Rohit-Kumar-Meena/4-Dof-Scara-Robot/SCARA.jpeg

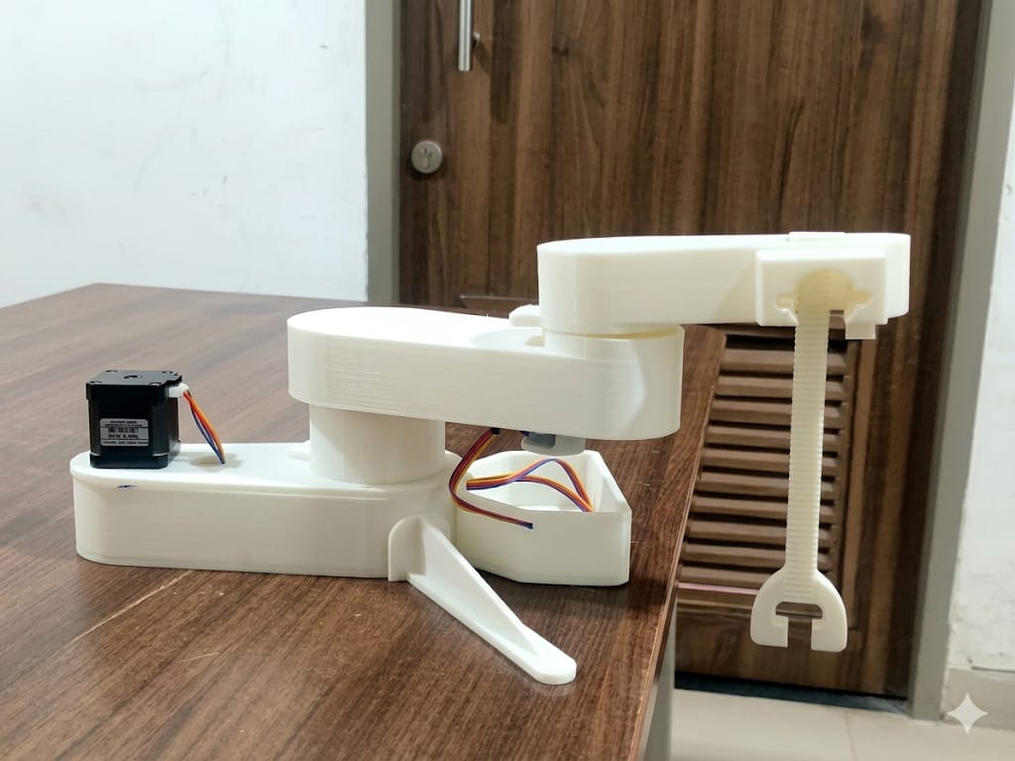
SCARA.jpeg
