Rohit-Kumar-Meena/4-Dof-Scara-Robot/scara report.pdf

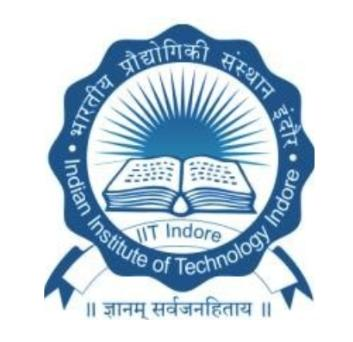
[picture p2: figure]

ME- 310

## Design of Machine Elements

# 4 DOF-Scara

## Group 5

Name | Roll No.
Davinderpal Singh | 230003020
Sumit Sarkar | 230003075
Gulshan Choudhary | 230003024
Rohit Ranjan | 230003059
Rohit Kumar Meena | 230003058
Koyna Pandit | 230003034
Ashish Jaiswal | 230003010
Abhishek Singh | 230003002
Paidi Nisanth | 230003049

## Course Coordinator

## Prof. Krishna Mohan Kumar

## Department of Mechanical Engineeering

## IIT Indore

ABSTRACT

This project focuses on the design, analysis, and development of a SCARA (Selective Compliance Assembly Robot Arm) robot for industrial pick-and-place applications. The robot was designed using CAD software and analyzed under different loading conditions to evaluate its structural strength and operational performance. Static analysis, dynamic analysis, force analysis, bending moment calculations, critical stress calculations, and fatigue failure analysis were performed to ensure safe operation of the mechanism. Different hardware components such as servo motors, controller boards, bearings, shafts, and link mechanisms were integrated to develop the complete robotic system. The proposed design provides advantages such as compact structure, reduced weight, improved motion accuracy, and ease of operation. The project demonstrates the practical implementation of robotic automation for lightweight industrial applications.

INTRODUCTION

Industrial automation has become an important requirement in modern manufacturing industries due to the increasing demand for productivity, precision, and reduced human effort. Robotic systems are widely used for repetitive tasks such as pick-and-place operations, assembly, packaging, and material handling. However, many industrial robotic systems are expensive and complex for small-scale applications.

The main motivation behind this project is to develop a compact, economical, and efficient SCARA robot capable of performing automated operations with good positional accuracy and structural stability. The SCARA mechanism was selected because of its high-speed motion, simple construction, easy control, and suitability for industrial automation applications.

The project also aims to understand practical engineering concepts such as mechanism design, force analysis, stress analysis, fatigue failure, and system integration. The developed system provides an educational and industrial platform for studying robotic automation and mechanical system design.

CAD DESIGN

The complete SCARA robot was designed using CAD software to visualize the structure, dimensions, assembly, and working mechanism before fabrication. Different parts such as the base frame, rotating arms, motor mounts, shafts, and end effector were modeled separately and assembled to verify proper motion and alignment.

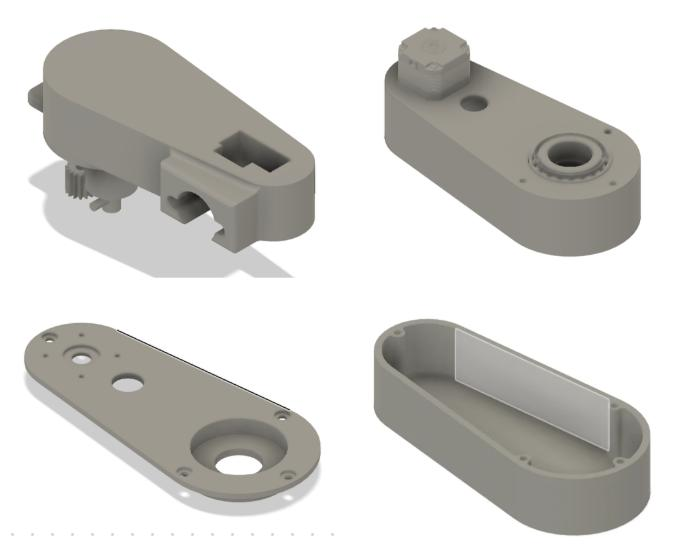
[picture p3: figure]

Different Components

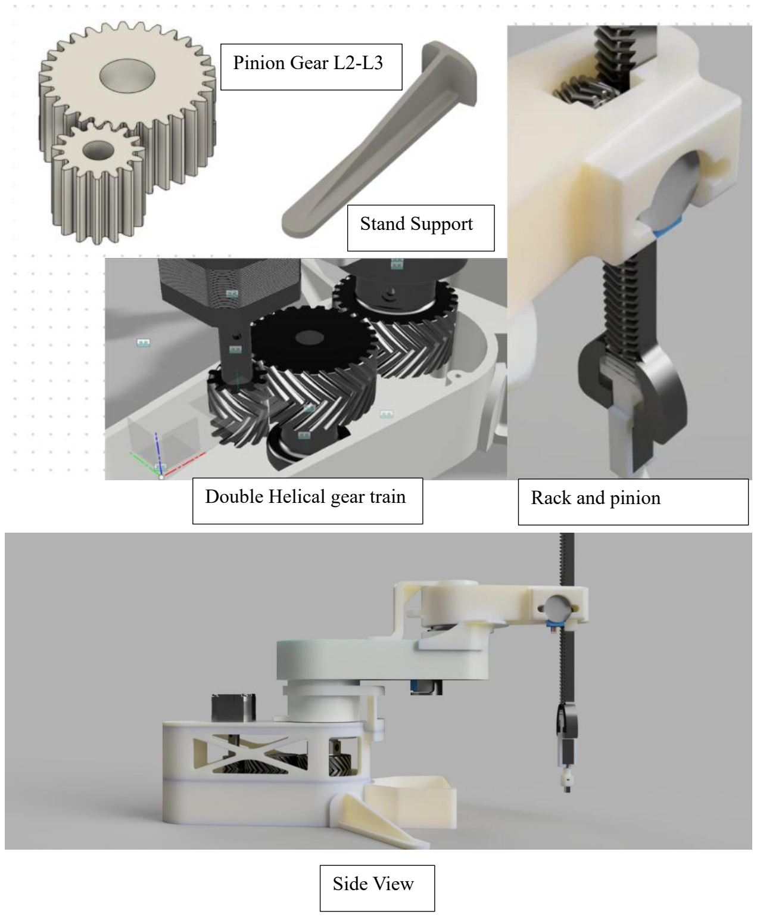
[picture p4: page 4]

Double Helical gear train | Rack and pinion

Stand Support

Pinion Gear L2-L3

Side View

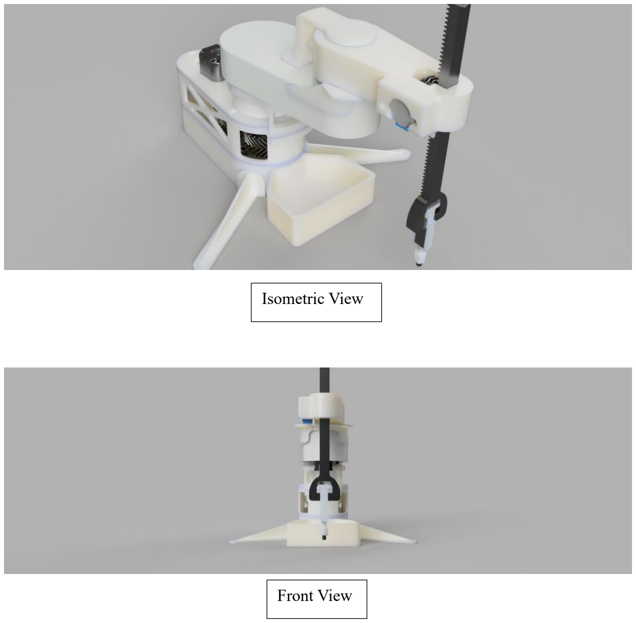
[picture p5: page 5]

Isometric View

Front View

DIMENSIONS

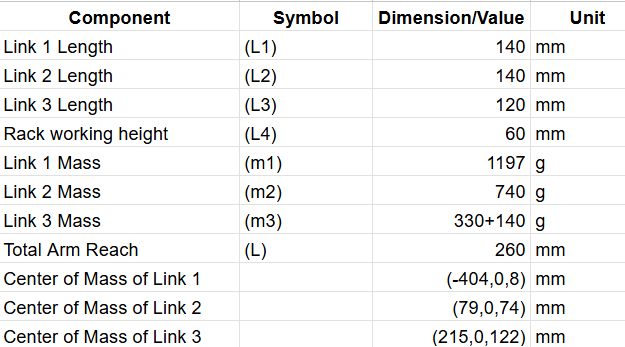
[picture p6: figure]

LINK EXPLANATION

Link 1

Link 1 is the base has a length of 140 mm. It acts as the primary supporting arm of the
SCARA mechanism and transfers motion from the motor to the remaining links. The mass of Link 1 is approximately 1197 g.

Link 2

Link 2 is connected to Link 1 through revolute Joint J2 and also has a length of 140 mm. This link provides additional reach and flexibility to the robotic arm. The mass of Link 2 is approximately 740 g.

Link 3

Link 3 is the end link of the mechanism with a length of 120 mm. It carries the end effector and payload during operation. The total mass acting on Link 3 is approximately 330+140.

As our desired workspace has an extent of 260 mm, therefore chosen the dimension of link2 and link3 as 140 and 120 respectively. For link 1,reference from prior design is taken by taking the same ratio of links.

Joint Mechanism

The robotic arm consists of two revolute joints:

- J1: Base rotational joint
- J2: Intermediate rotational joint
- J3: Rack and pinion between link 3 and 4
- J4: Rotational motion of geared motor at end effector

The links were designed to provide sufficient stiffness and strength while maintaining smooth motion and reduced vibration during operation.

Kinematics equations (DH Table):

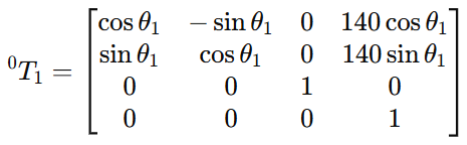
[picture p7: figure]
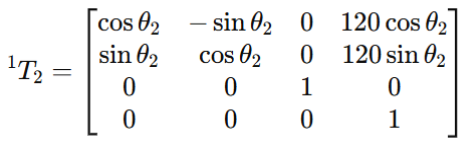
[picture p8: figure]
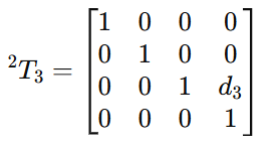
[picture p9: figure]

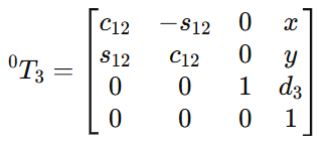
[picture p10: figure]
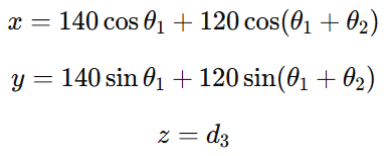
[picture p11: figure]

### Centre of Gravity of each part

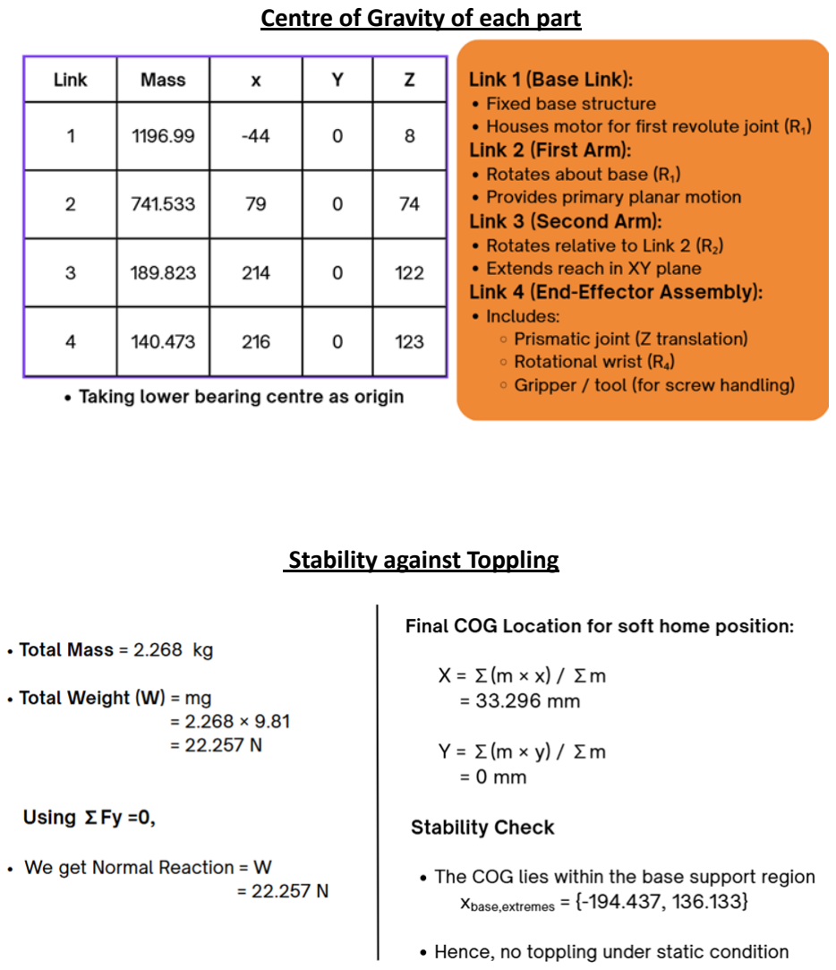
[picture p12: page 9]

### Stability against Toppling

LOADING ASSUMPTIONS:

STATIC ANALYSIS:

Static analysis was performed to determine the deformation and equivalent stress developed in the robotic structure under stationary loading conditions.

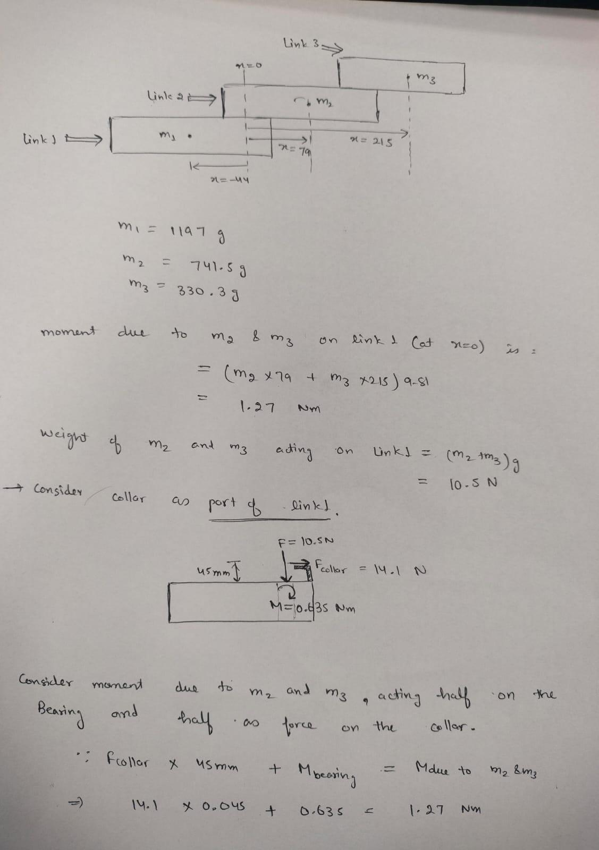
[picture p13: figure]

DYNAMIC ANALYSIS :

Dynamic analysis was performed to study the motion characteristics and inertia effects during robotic operation.

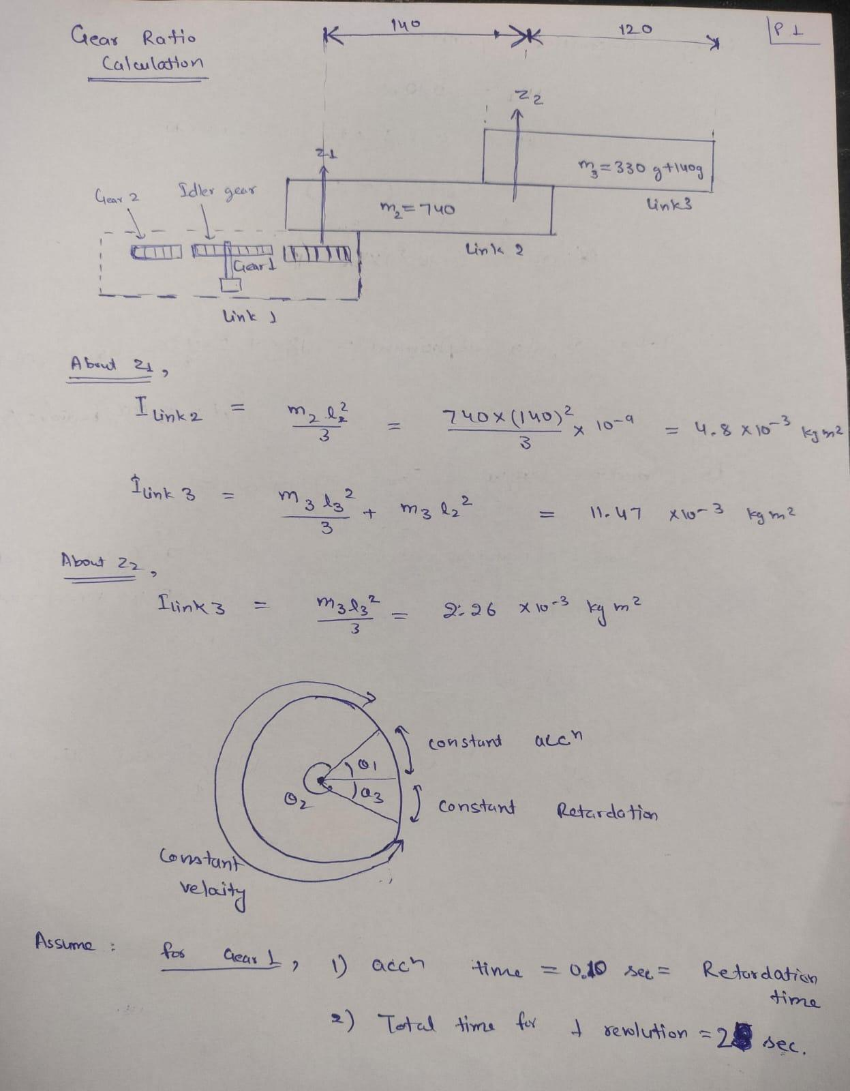
[picture p14: figure]

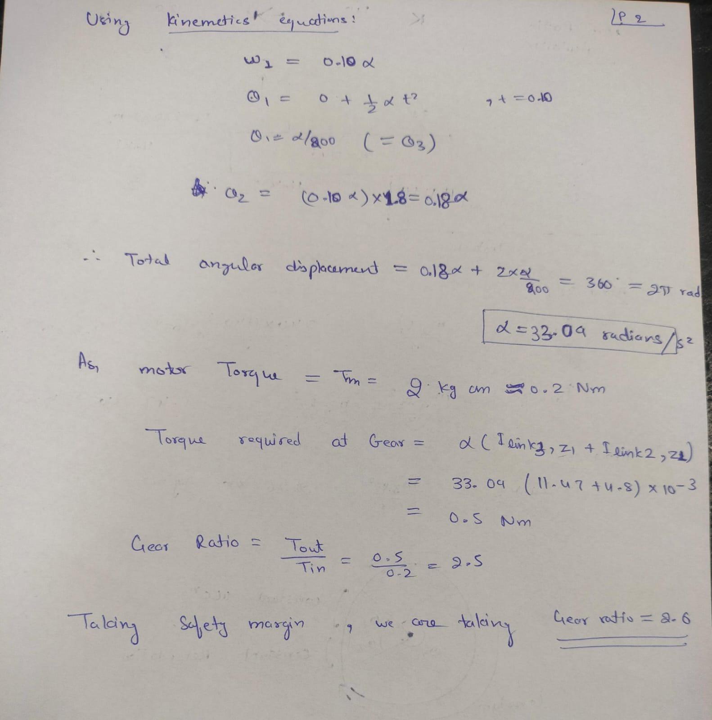
[picture p15: figure]

Gear Ratio Calculation

- The gear ratio calculation was performed to determine the torque requirement for smooth motion of the SCARA robotic arm.
- The masses and lengths of Link 2 and Link 3 were considered for rotational inertia calculations.
- Moments of inertia were calculated about axes Z1 and Z2.
- The motion profile of the robotic arm was assumed to consist of:
- Constant acceleration
- Constant velocity
- Constant retardation

- A total time of 2 seconds was assumed for one complete revolution.
- The obtained inertia values were used for further torque and gear ratio calculations.

Kinematic Equations and Gear Ratio

- Kinematic equations were used to determine the angular acceleration of the robotic arm.
- Angular displacement during acceleration and constant velocity motion was calculated.
- The total angular displacement was considered equal to one complete revolution.
- Motor torque provided by the selected motor was compared with the required output torque.
- Gear ratio was calculated based on torque transmission requirements.
- A safety margin was considered while selecting the final gear ratio.
- Final gear ratio selected for the mechanism was 2.6.

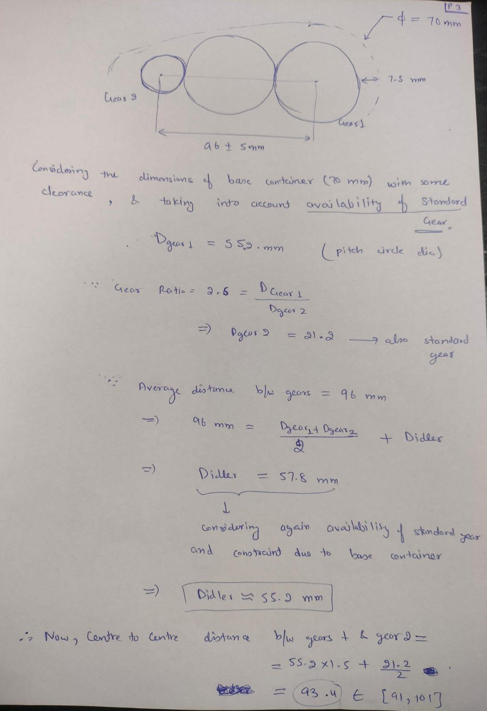
[picture p16: figure]

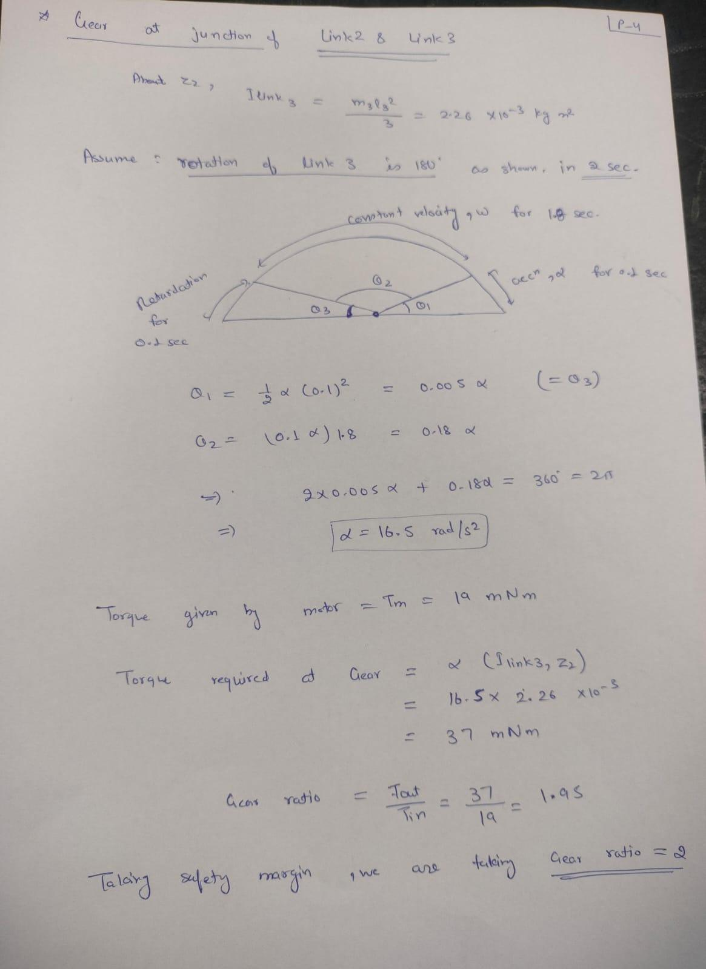
[picture p17: figure]

Gear Dimensions Calculation

- Gear dimensions were selected considering the space limitations of the base container.
- Standard gear sizes available in the market were considered during design selection.
- Pitch circle diameters of Gear 1 and Gear 2 were calculated using the required gear ratio.
- An idler gear was introduced to maintain proper center distance and motion transfer.
- Clearance between gears was provided to avoid interference during operation.
- Final gear dimensions were selected based on:
- Gear availability
- Compact design
- Proper center distance
- Smooth power transmission

Gear Calculation at Junction of Link 2 and Link 3

- Gear calculations were performed at the junction of Link 2 and Link 3 to determine torque transmission requirements.
- The moment of inertia of Link 3 about axis Z2Z_2Z2 was calculated.
- Motion of Link 3 was assumed to be 180° rotation within 2 seconds.
- The motion profile included acceleration, constant velocity, and retardation regions.
- Angular acceleration was determined using kinematic relations.
- Required output torque at the gear was calculated using rotational inertia and angular acceleration.
- Gear ratio was obtained by comparing required torque and motor torque.
- A safety margin was included while selecting the final gear ratio.
- Final gear ratio selected at the junction was 2.0.

Fatigue Analysis Using S-N Curve
Fatigue analysis of the robotic components was performed using the S-N curve for PLA material to study the effect of cyclic loading.

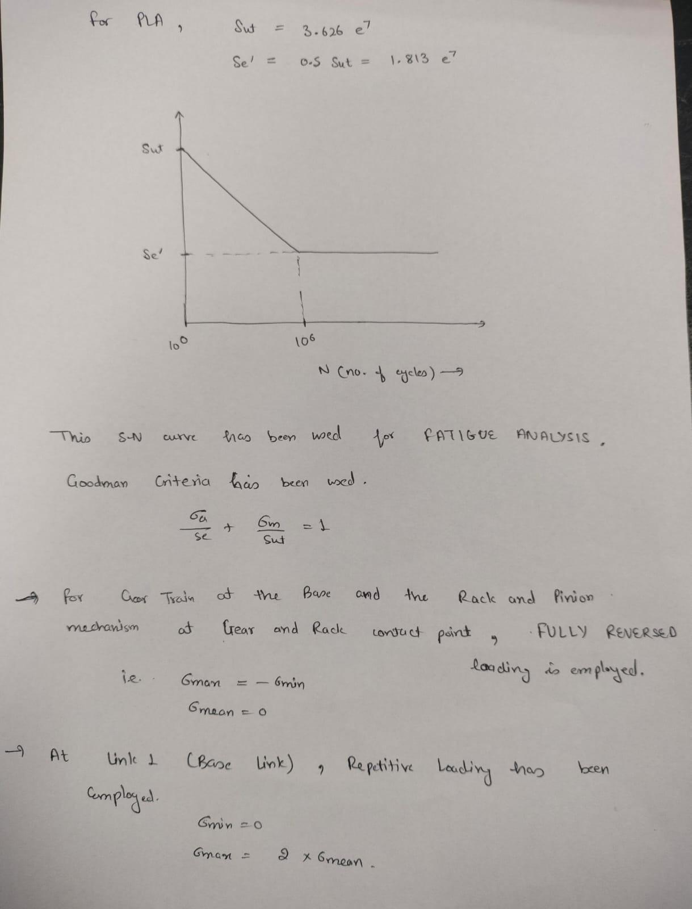
[picture p18: figure]

- The Goodman failure criterion was used to evaluate fatigue safety under fluctuating stresses.
- Fully reversed loading condition was considered for the gear train and rack-and-pinion contact region, where tensile and compressive stresses alternate continuously.
- Repetitive loading condition was considered for Link 1 (base link), where stress varies from zero to maximum value during operation.
- The fatigue analysis helped in predicting the durability and safe operating life of the robotic mechanism under repeated loading conditions.

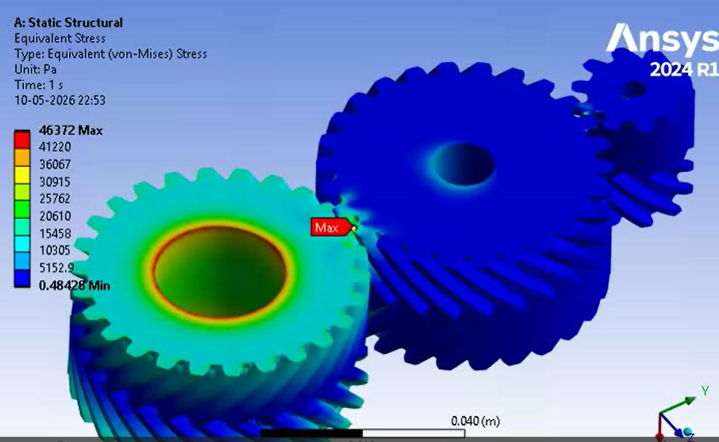
[picture p19: figure]

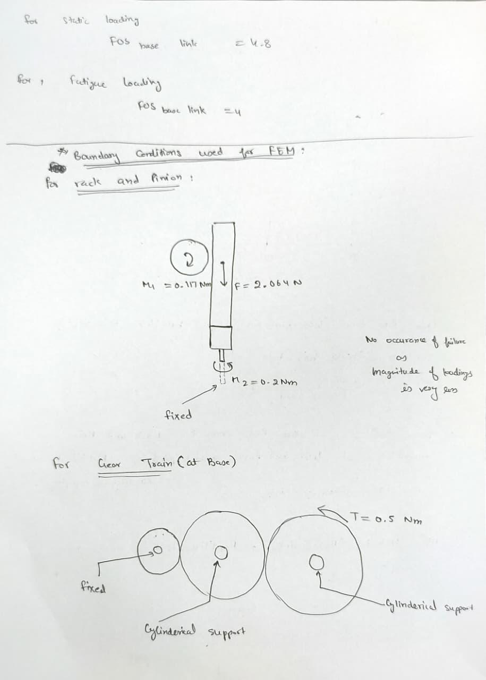
[picture p20: figure]
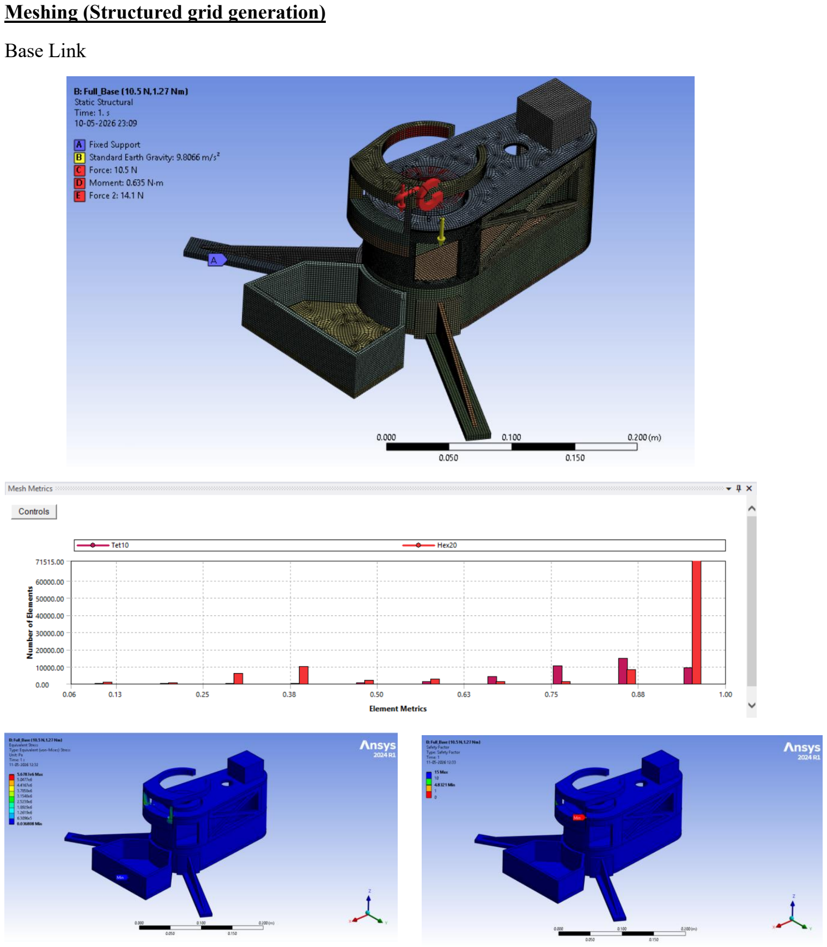
[picture p21: page 20]

Meshing (Structured grid generation)

Base Link

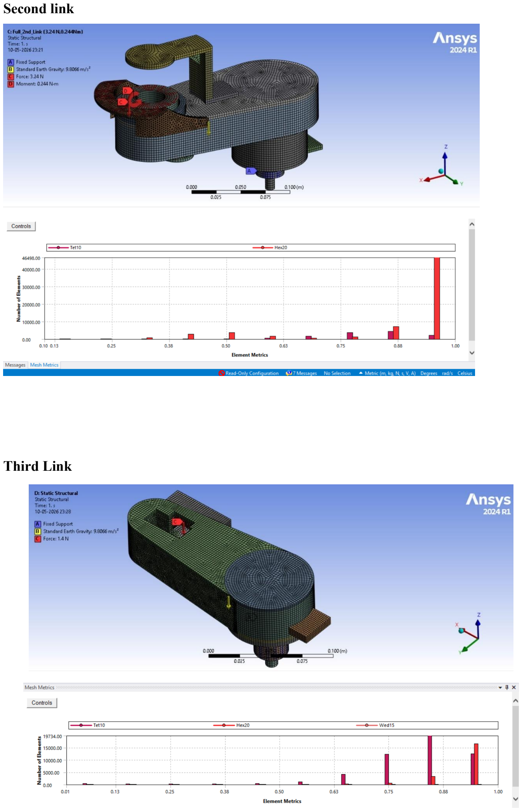
[picture p22: page 21]

Second link

Third Link

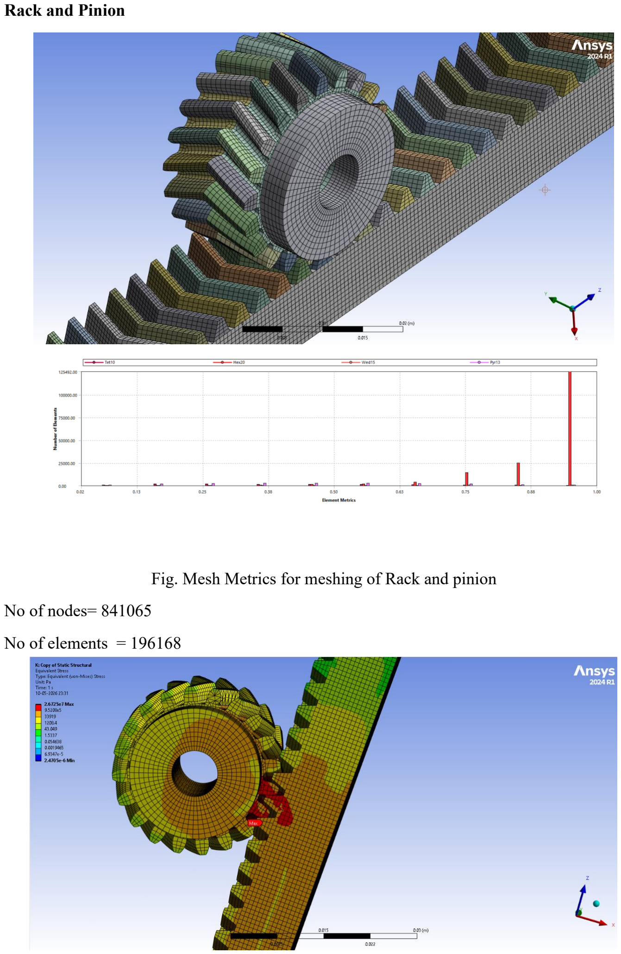
[picture p23: page 22]

Rack and Pinion

Fig. Mesh Metrics for meshing of Rack and pinion

No of nodes= 841065

No of elements = 196168

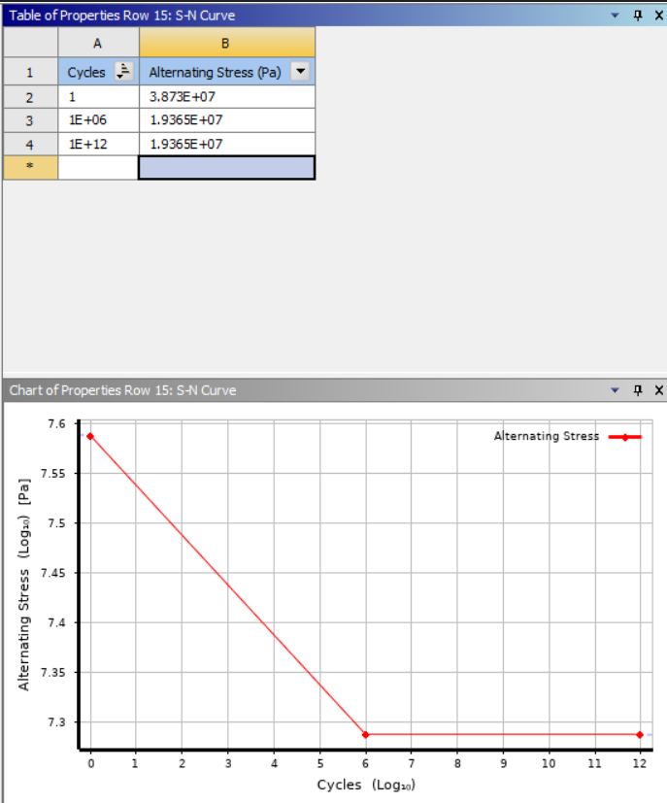
[picture p24: figure]
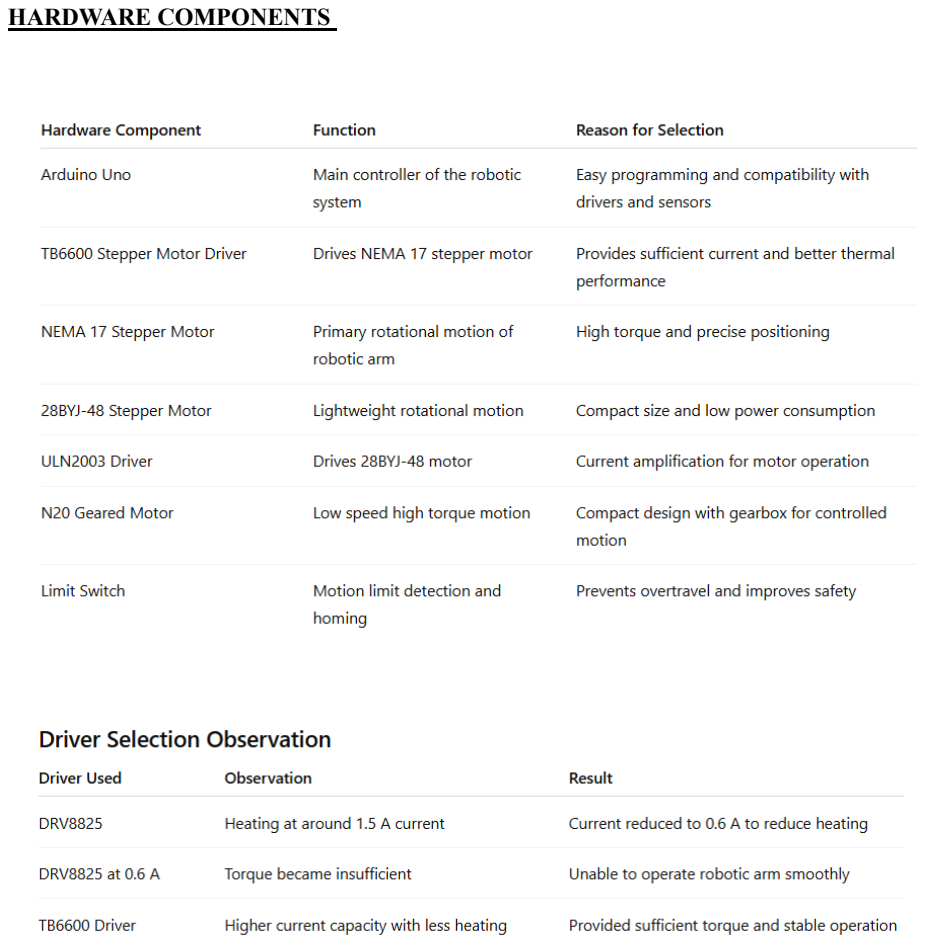
[picture p25: page 24]

HARDWARE COMPONENTS

## Arduino Code

// ============================================================ // SCARA ROBOT - FULL MANUAL CONTROL
//
// LINK 1 -> NEMA17 + TB6600
// LINK 2 -> 28BYJ-48 + ULN2003
// LINK 3 -> 28BYJ-48 + ULN2003 + DC MOTOR //
// FEATURES:
// 1. Move Link 1 by steps (+ or -)
// 2. Move Link 2 by steps (+ or -) // 3. Calibrate Link 3
// 4. Link 3 Forward Sequence
// 5. Link 3 Reverse Sequence
// ============================================================

#include <AccelStepper.h>

// ============================================================ // LINK 1 -> NEMA17 + TB6600
// ============================================================ #define J1_STEP_PIN 3
#define J1_DIR_PIN 2

#define J1_LIMIT_PIN A3

// ============================================================ // LINK 2 -> 28BYJ-48 + ULN2003
// ============================================================ #define J2_IN1 8
#define J2_IN2 10

#define J2_IN3 9

#define J2_IN4 11

#define J2_LIMIT_PIN 13

// ============================================================ // LINK 3 -> 28BYJ-48 + ULN2003
// ============================================================ #define J3_IN1 4
#define J3_IN2 6

#define J3_IN3 5

#define J3_IN4 7

#define J3_LIMIT_PIN 12

// ============================================================ // DC MOTOR PINS
// ============================================================ #define ENA A0
#define INA1 A1

#define INA2 A2

// ============================================================ // MOTOR TYPES
// ============================================================ #define DRIVER_INTERFACE 1
#define FULL4WIRE 4

// ============================================================ // MOTOR OBJECTS
// ============================================================ AccelStepper joint1(DRIVER_INTERFACE,
J1_STEP_PIN,
J1_DIR_PIN);

AccelStepper joint2(FULL4WIRE, J2_IN1,
J2_IN2,
J2_IN3,
J2_IN4);

AccelStepper joint3(FULL4WIRE, J3_IN1,
J3_IN2,
J3_IN3,
J3_IN4);

// ============================================================ // VARIABLES
// ============================================================ String command;
long steps;

// ============================================================ // LIMIT SWITCH FUNCTION
// ============================================================ bool limitTriggered(int pin)
{
return (digitalRead(pin) == LOW);
}

// ============================================================ // DC MOTOR FUNCTIONS

// ============================================================ void stopDCMotor()
{
digitalWrite(INA1, LOW);
digitalWrite(INA2, LOW);

analogWrite(ENA, 0);
}

void rotateDCMotorForward(int speedValue) {
digitalWrite(INA1, HIGH);
digitalWrite(INA2, LOW);

analogWrite(ENA, speedValue);
}

void rotateDCMotorBackward(int speedValue) {
digitalWrite(INA1, LOW);
digitalWrite(INA2, HIGH);

analogWrite(ENA, speedValue);
}

// ============================================================ // LINK 3 CALIBRATION
// ============================================================ void calibrateLink3()
{
Serial.println("================================="); Serial.println("LINK 3 CALIBRATION STARTED"); Serial.println("=================================");

joint3.setMaxSpeed(300);
joint3.setAcceleration(100);

// Move toward limit switch joint3.moveTo(-100000);

while (!limitTriggered(J3_LIMIT_PIN)) {
joint3.run();
}

Serial.println("Limit Switch Triggered");

joint3.stop();

joint3.runToPosition();

joint3.setCurrentPosition(0);

delay(500);

// Move slightly away from switch Serial.println("Moving to Home Position");

joint3.move(50);

while (joint3.distanceToGo() != 0) {
joint3.run();
}

joint3.setCurrentPosition(0);

Serial.println("Calibration Complete");
}

// ============================================================ // MOVE LINK 1
// ============================================================ void moveLink1(long targetSteps)
{
Serial.print("Moving Link 1 Steps = ");
Serial.println(targetSteps);

joint1.setMaxSpeed(800);
joint1.setAcceleration(500);

// Positive -> Forward
// Negative -> Reverse
joint1.move(targetSteps);

while (joint1.distanceToGo() != 0) {
joint1.run();
}

Serial.println("Link 1 Motion Complete");
}

// ============================================================ // MOVE LINK 2
// ============================================================ void moveLink2(long targetSteps)

{
Serial.print("Moving Link 2 Steps = "); Serial.println(targetSteps);

joint2.setMaxSpeed(500);
joint2.setAcceleration(300);

// Positive -> Forward
// Negative -> Reverse
joint2.move(targetSteps);

while (joint2.distanceToGo() != 0) {
joint2.run();
}

Serial.println("Link 2 Motion Complete");
}

// ============================================================ // LINK 3 FORWARD SEQUENCE
// ============================================================ void forwardSequence()
{
Serial.println("================================="); Serial.println("FORWARD SEQUENCE STARTED"); Serial.println("=================================");

// ========================================================== // FAST MOVE
// ========================================================== joint3.setMaxSpeed(600);
joint3.setAcceleration(300);

joint3.move(1200);

while (joint3.distanceToGo() != 0) {
joint3.run();
}

Serial.println("1200 Steps Reached");

// ========================================================== // START DC MOTOR FORWARD
// ========================================================== Serial.println("Starting DC Motor Forward");

rotateDCMotorForward(80);

delay(2000);

// ========================================================== // SLOW MOVE
// ========================================================== joint3.setMaxSpeed(250);
joint3.setAcceleration(200);

joint3.move(700);

while (joint3.distanceToGo() != 0) {
joint3.run();
}

// ========================================================== // STOP EVERYTHING
// ========================================================== stopDCMotor();

Serial.println("Forward Sequence Complete");
}

// ============================================================ // LINK 3 REVERSE SEQUENCE
// ============================================================ void reverseSequence()
{
Serial.println("================================="); Serial.println("REVERSE SEQUENCE STARTED"); Serial.println("=================================");

// ========================================================== // START DC MOTOR REVERSE
// ========================================================== rotateDCMotorBackward(80);

delay(1000);

// ========================================================== // REVERSE STEPPER
// ========================================================== joint3.setMaxSpeed(600);
joint3.setAcceleration(300);

joint3.move(-1000);

while (joint3.distanceToGo() != 0) {
joint3.run();
}

// ========================================================== // STOP EVERYTHING
// ========================================================== stopDCMotor();

Serial.println("Reverse Sequence Complete");
}

// ============================================================ // SETUP
// ============================================================ void setup()
{
Serial.begin(9600);

// ========================================================== // LIMIT SWITCH PINS
// ========================================================== pinMode(J1_LIMIT_PIN, INPUT_PULLUP);
pinMode(J2_LIMIT_PIN, INPUT_PULLUP);
pinMode(J3_LIMIT_PIN, INPUT_PULLUP);

// ========================================================== // DC MOTOR PINS
// ========================================================== pinMode(ENA, OUTPUT);
pinMode(INA1, OUTPUT);
pinMode(INA2, OUTPUT);

stopDCMotor();

Serial.println("================================="); Serial.println("SCARA ROBOT READY"); Serial.println("=================================");
}

// ============================================================ // LOOP
// ============================================================ void loop()
{
Serial.println();

Serial.println("================================="); Serial.println("ENTER COMMAND:");
Serial.println("1 = Move Link 1");
Serial.println("2 = Move Link 2");
Serial.println("3 = Calibrate Link 3");
Serial.println("f = Link 3 Forward Sequence"); Serial.println("r = Link 3 Reverse Sequence"); Serial.println("=================================");

// Wait for user input
while (Serial.available() == 0)
{
}

command = Serial.readStringUntil('\n');

command.trim();

// ========================================================== // LINK 1 CONTROL
// ========================================================== if (command == "1")
{
Serial.println("Enter Steps for Link 1:");
Serial.println("Positive = Forward"); Serial.println("Negative = Reverse");

while (Serial.available() == 0)
{
}

steps = Serial.parseInt();

while (Serial.available()) {
Serial.read();
}

moveLink1(steps);
}

// ========================================================== // LINK 2 CONTROL
// ========================================================== else if (command == "2")
{
Serial.println("Enter Steps for Link 2:");
Serial.println("Positive = Forward");

Serial.println("Negative = Reverse");

while (Serial.available() == 0)
{
}

steps = Serial.parseInt();

while (Serial.available()) {
Serial.read();
}

moveLink2(steps);
}

// ========================================================== // LINK 3 CALIBRATION
// ========================================================== else if (command == "3")
{
calibrateLink3();
}

// ========================================================== // LINK 3 FORWARD
// ========================================================== else if (command == "f")
{
forwardSequence();
}

// ========================================================== // LINK 3 REVERSE
// ========================================================== else if (command == "r")
{
reverseSequence();
}

// ========================================================== // INVALID COMMAND
// ========================================================== else
{
Serial.println("Invalid Command");
}

Serial.println();
Serial.println("NEXT COMMAND READY");
} FUTURE SCOPE

Future improvements for the project include:

- Integration of machine vision systems
- IoT-based monitoring and control
- Artificial intelligence for autonomous operation
- Increased payload capacity
- Wireless control system
- Advanced motion planning algorithms

These developments can improve industrial applicability and operational efficiency.

CONCLUSION

The project successfully demonstrated the design, analysis, and development of a SCARA robotic mechanism for industrial automation applications. CAD modeling, force analysis, static analysis, dynamic analysis, bending moment calculations, and fatigue analysis were performed to ensure structural safety and efficient operation.

The developed robotic system provides advantages such as compact design, reduced weight, improved motion accuracy, and low operational cost. The obtained factor of safety confirms that the structure can safely withstand the applied loading conditions.

The project provides practical understanding of robotic mechanism design, stress analysis, and system integration for industrial automation applications.

REFERENCES

Video which is taken as reference (https://www.youtube.com/watch?v=1QHJksTrk8s)
